dramco-iwast/motherboard/hardware/Motherboard v2/photo_2021-06-02_11-23-46.jpg

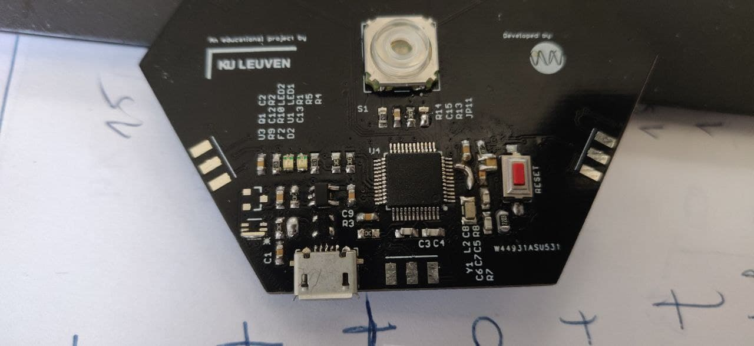
hardware/Motherboard v2/photo_2021-06-02_11-23-46.jpg
