dramco-iwast/motherboard/README.md

# motherboard
Design files (soft- and hardware) for the IWAST motherboard.

Needs reorganization.
