dramco-iwast/motherboard/hardware/Motherboard_v2_bom.xlsx

Qty | Value | Device | Package | Parts | Description | Manufacturer Part Number (MPN) | Ordercode Farnell | Ordercode Mouser | Type
2 |  | JUMPER-PAD-2-NC_BY_TRACENO_SILK | PAD-JUMPER-2-NC_BY_TRACE_NO_SILK | SJ1, SJ2
1 |  | JUMPER-SMT_3_1-NC_TRACE_SILK | SMT-JUMPER_3_1-NC_TRACE_SILK | JP11 | Normally closed trace jumper (1 of 2 connections)
2 |  | LEDCHIP-LED0603 | CHIP-LED0603 | LED1, LED2 | LED | KP-2012QBC-D | 2217974 |  | Tape en reel, afgesneden
1 |  | MOSFET_PCH-DMG2307L | SOT23-3 | Q1 | P-channel MOSFETs | DMG2307L | 2061518 |  | Tape en reel, afgesneden
1 |  | PINHD-1X1 | 1X01 | JP2 | PIN HEADER
6 |  | PINHD-2X3 | 2X03 | JP3, JP4, JP5, JP6, JP7, JP8 | PIN HEADER | M20-7830346 | 7991983 |  | Per stuk
1 |  | WE-CBA_0603(WB/HS) | WE-CBA_0603(W=2.2) | L2 | WE-CBA SMD EMI Suppression Ferrite Bead | 782631331 | 3551389 |  | Tape en reel, afgesneden
11 | 100n | C-EUC0603 | C0603 | C1, C2, C3, C4, C5, C8, C9, C12, C13, C15, C17 | CAPACITOR, European symbol | C0603C104Z4VACTU | 2522395 |  | Tape en reel, afgesneden
9 | 10k | R-EU_R0603 | R0603 | R3, R4, R5, R6, R7, R9, R10, R13, R14 | RESISTOR, European symbol | MC0100W0603110K | 2845751 |  | Tape en reel, afgesneden
1 | 10u | C-EUC0805 | C0805 | C16 | CAPACITOR, European symbol | C0805C106Z8VACTU | 2725611 |  | Reel
2 | 15p | C-EUC0603 | C0603 | C6, C7 | CAPACITOR, European symbol | C0603C150K4GACTU | 2773124 |  | Tape en reel, afgesneden
1 | 30062100 | 30062100 | 30062101 | S1 | Tactile Switches TACTILE | 30062114 |  | 979-3006.2114 | Not specified
1 | 32.768kHz | CRYSTAL3.2X1.5MM | CRYSTAL-SMD-3.2X1.5MM | Y1 | Various standard crystals. Proven footprints. | ABS07-32.768KHZ-T | 2101347 |  | Tape en reel, afgesneden
1 | 330 | R-EU_R0603 | R0603 | R8 | RESISTOR, European symbol | MCWR06X3300FTL | 2447339 |  | Tape en reel, afgesneden
2 | 470 | R-EU_R0603 | R0603 | R1, R2 | RESISTOR, European symbol | RC0603JR-07470RL | 9233334 |  | Tape en reel, afgesneden
1 | ATSAMD21G-A | ATSAMD21G-A | TQFP-48 | U4 | Atmel SAMD21G SMART ARM-Based Microcontroller | ATSAMD21G18A-AUT | 2775015 |  | Per stuk
1 | KSS-2EG4430 | KSS-2EG4430 | KSS-2EG4430 | RESET | Size: 3x6mm | PTS636 SM43 SMTR LFS |  | 611-PTS636SM43SMTRLF | Reel / afgesneden
1 | LM66100DCKR | LM66100DCKR | DCK6_TEX | U3 |  | LM66100DCKR |  | 595-LM66100DCKR | Reel / afgesneden
1 | LP2985AIM5-3.3 | LP2985AIM5-3.3 | SOT25 | U1 | LP2985-N Micropower 150 mA Low-Noise Ultra Low-Dropout Regulator | LP2985AIM5-3.3/NOPB | 3122185 |  | Tape en reel, afgesneden
1 | PPTC_6V500MA | PPTC_6V500MA | 805 | F2 | Resettable Fuse PPTC | SMD0805B050TF | 3052501 |  | Tape en reel, afgesneden
1 | PRTR5V0U2X,215 | PRTR5V0U2X,215 | SOT143B | D2 | Ultra low capacitance double rail-to-rail ESD protection diode Check prices | PRTR5V0U2X,215 | 1524157 |  | Tape en reel, afgesneden
1 | RN2483 | RN2483 | RN2483 | U2 | RN2483 Microchip Low-Power Lora Transceiver Module | RN2483A-I/RM104 | 2920841 |  | Per stuk
8 | TPB1,27 | TPB1,27 | B1,27 | TP1, TP2, TP3, TP4, TP5, TP6, TP7, TP8 | Test pad
1 | U.FL | U.FL | U.FL | J1 | SMD antenna connector- WRL-09144 | U.FL-R-SMT-1(10) | 1688077 |  | Tape en reel, afgesneden
1 | USB-RECEPTABLE | USB-RECEPTABLE | FCI-10103594-0001LF | USB1 | USB Receptable | 10118194-0001LF | 2668482 |  | Tape en reel, afgesneden
