dramco-iwast/motherboard/hardware/MotherBoard v1/Motherboard_v1_Bottom.pdf

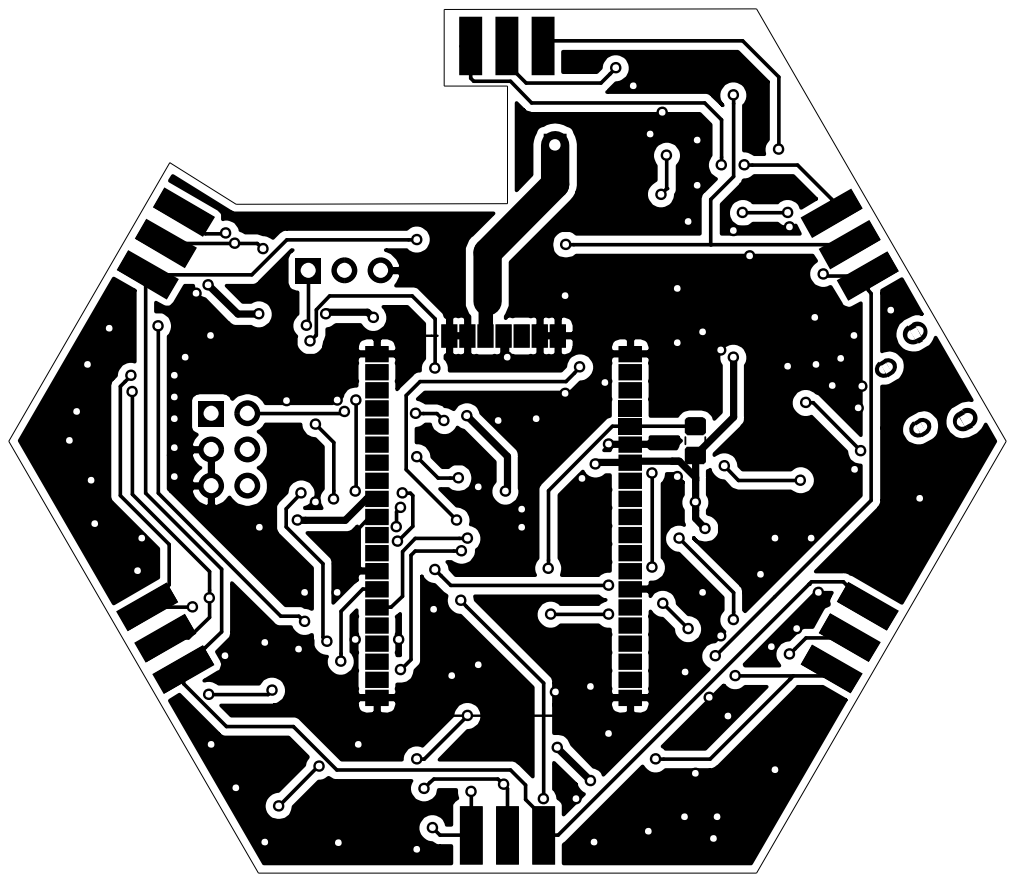
[picture p2: page 1]
