dramco-iwast/motherboard/hardware/MotherBoard v1/MotherBoard_v1_Schematic.pdf

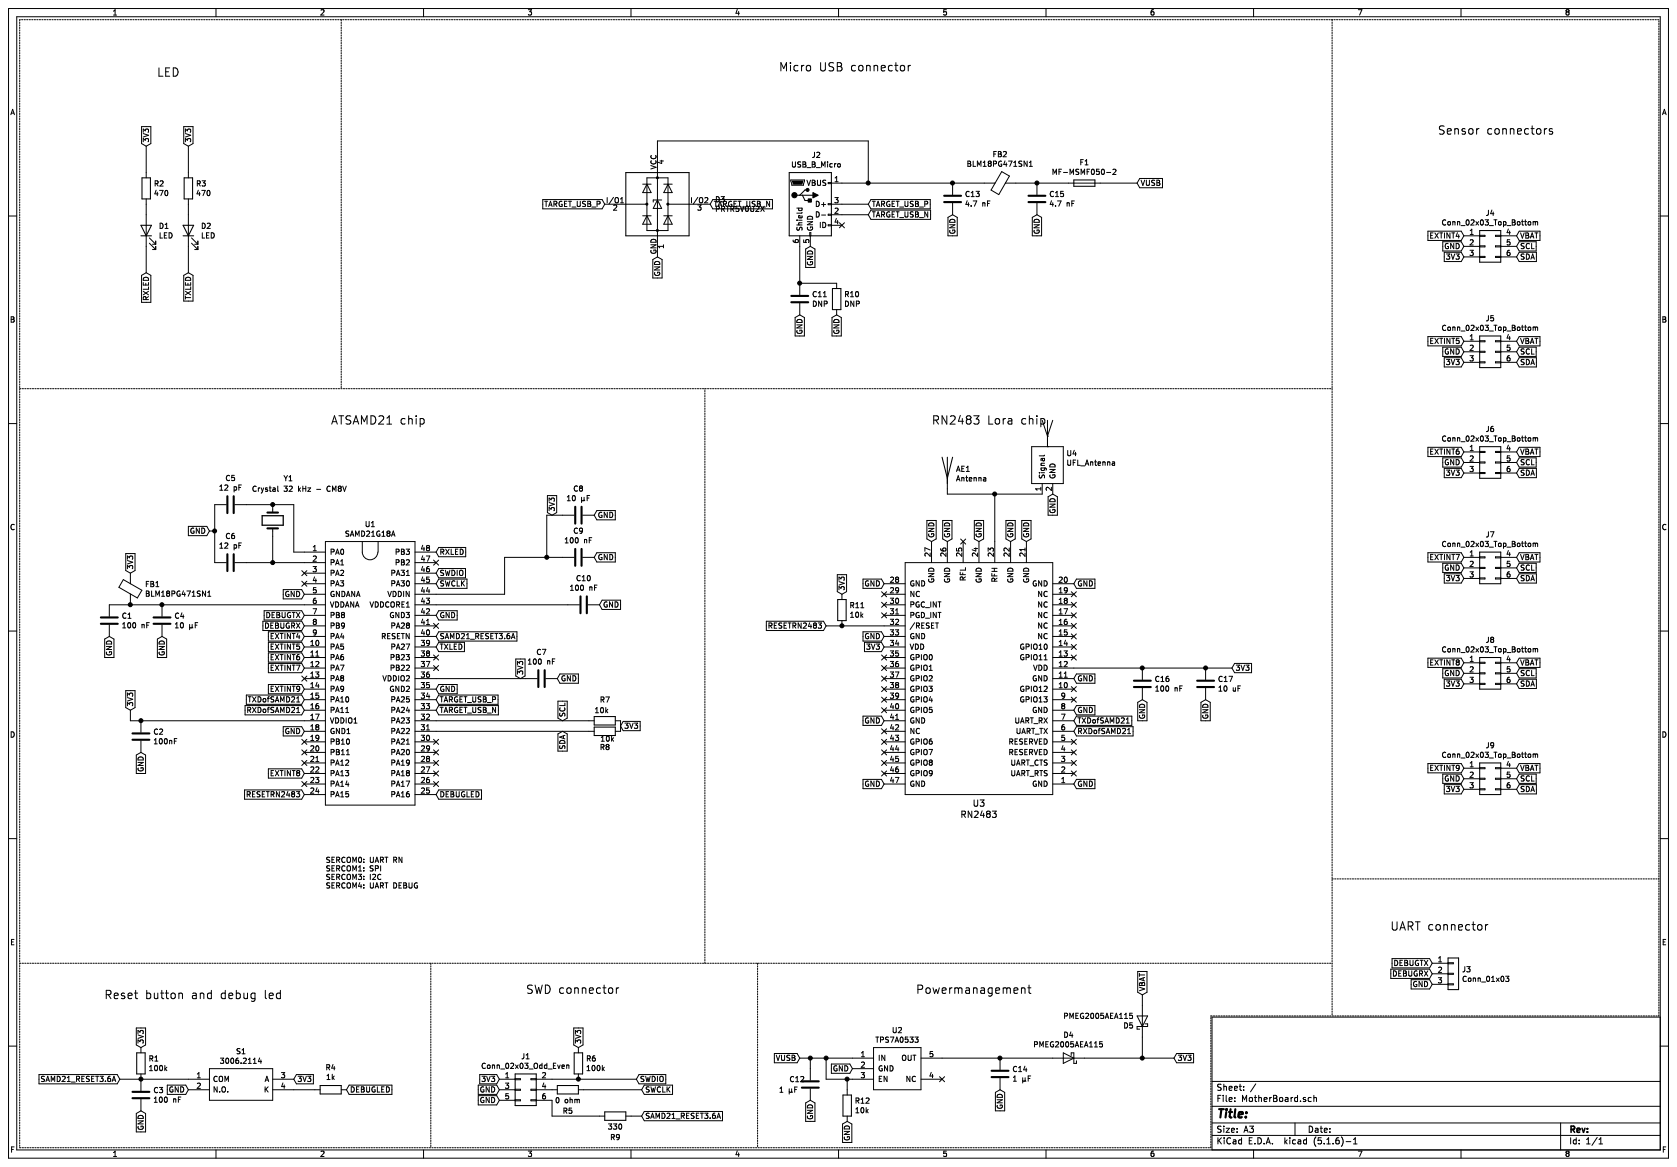
[picture p3: page 1]
