dramco-iwast/motherboard/hardware/MotherBoard v1/Motherboard_v1_Top.pdf

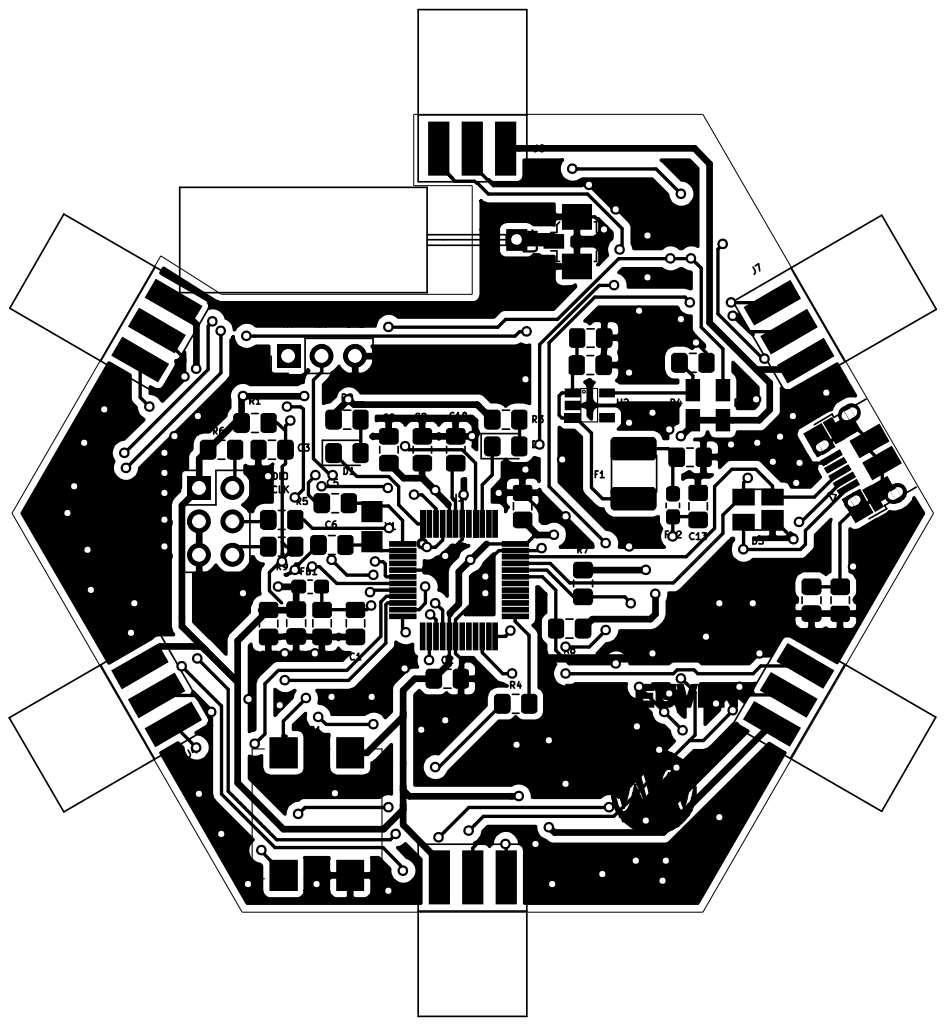
[picture p4: page 1]
