dramco-iwast/motherboard/hardware/MotherBoard v1/schematics/motherboard_back.pdf

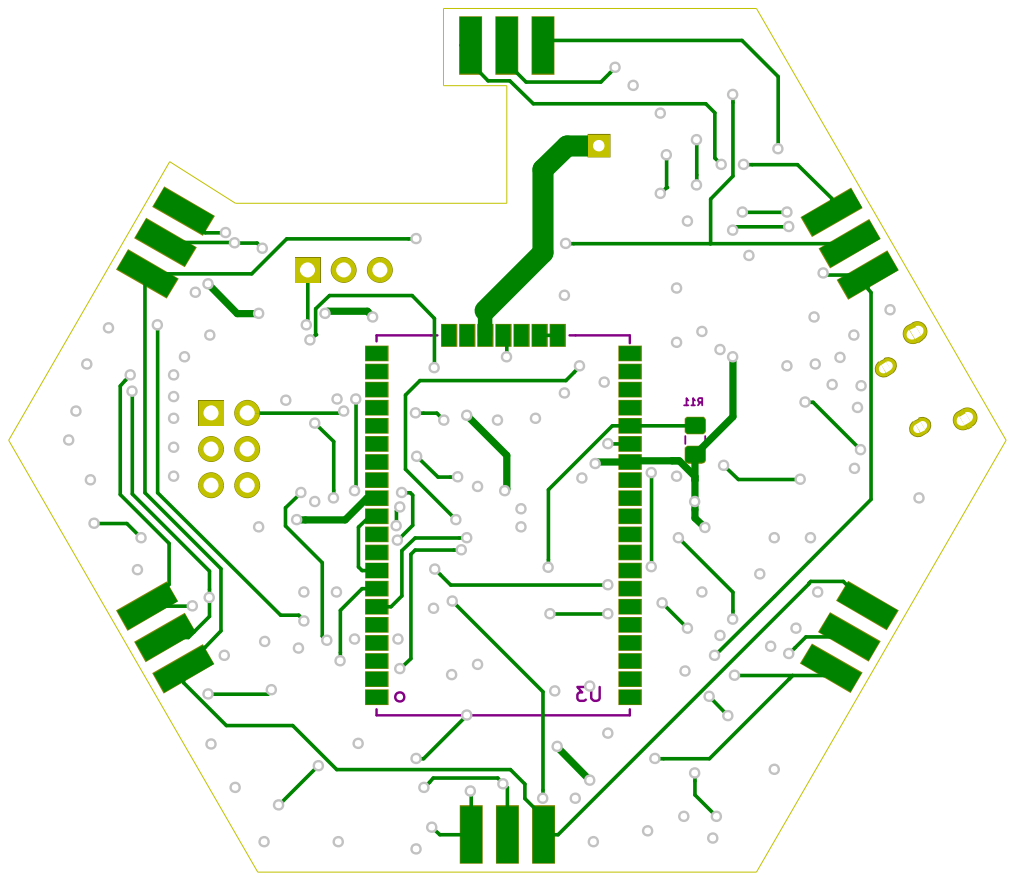
[picture p5: page 1]
