dramco-iwast/motherboard/hardware/MotherBoard v1/schematics/motherboard_front.pdf

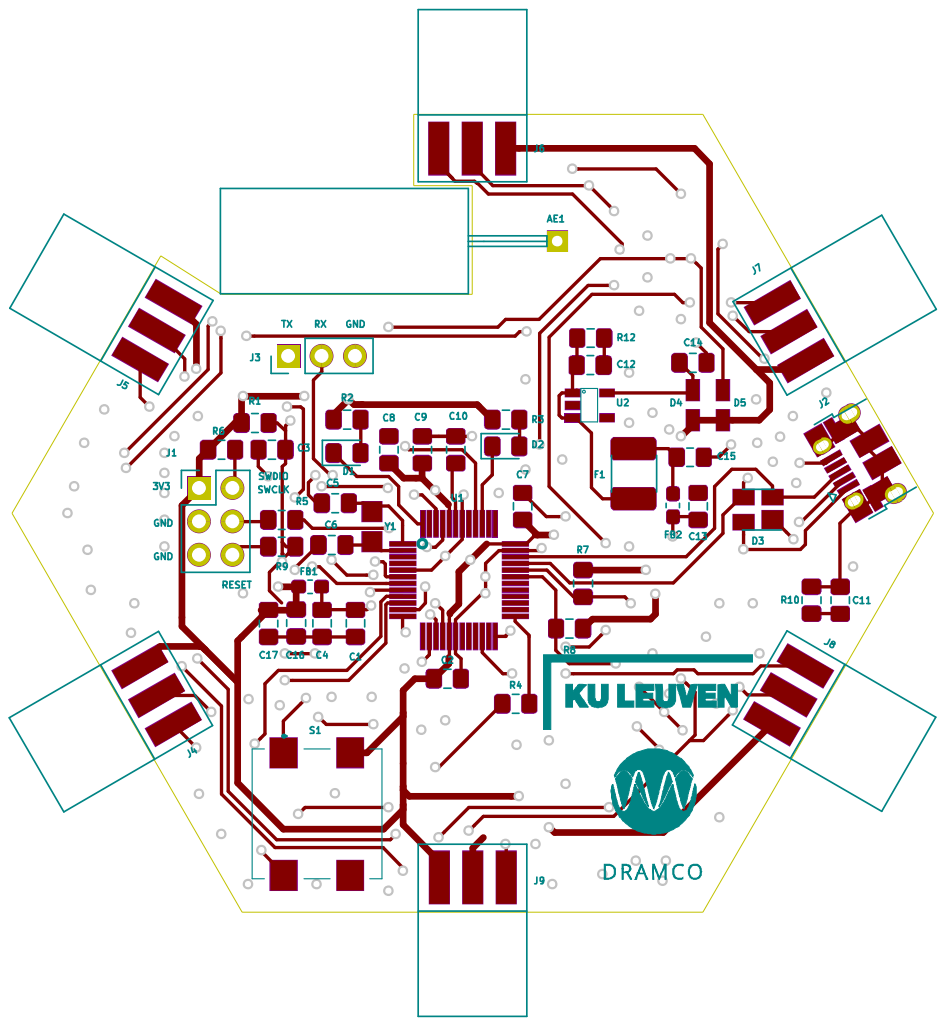
[picture p6: page 1]
