dramco-iwast/motherboard/hardware/MotherBoard v1/schematics/motherboard_schematic.pdf

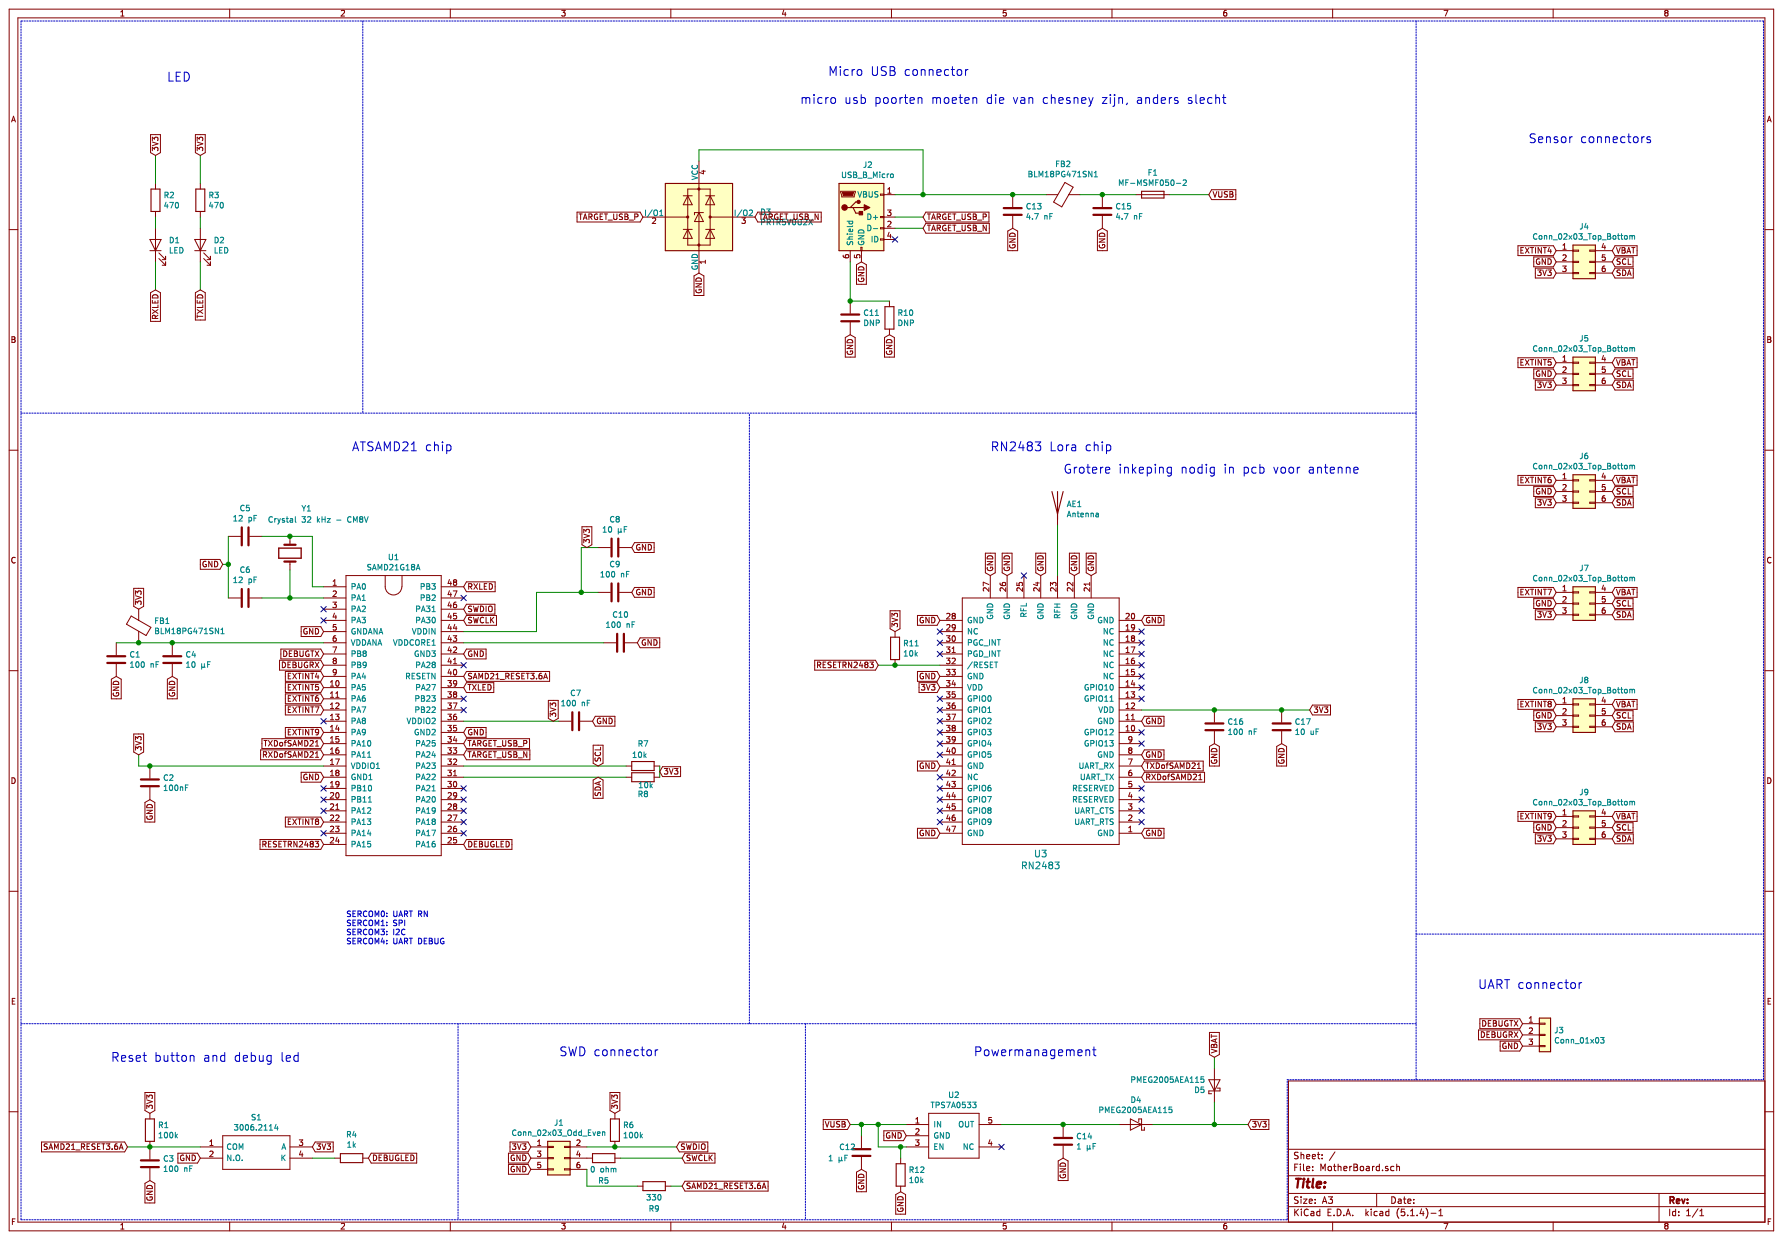
[picture p7: page 1]
