dramco-iwast/motherboard/hardware/MotherBoard v1/MotherBoard.kicad_pcb

## KiCad design hardware/MotherBoard v1/MotherBoard.kicad_pcb (2021-05-18)

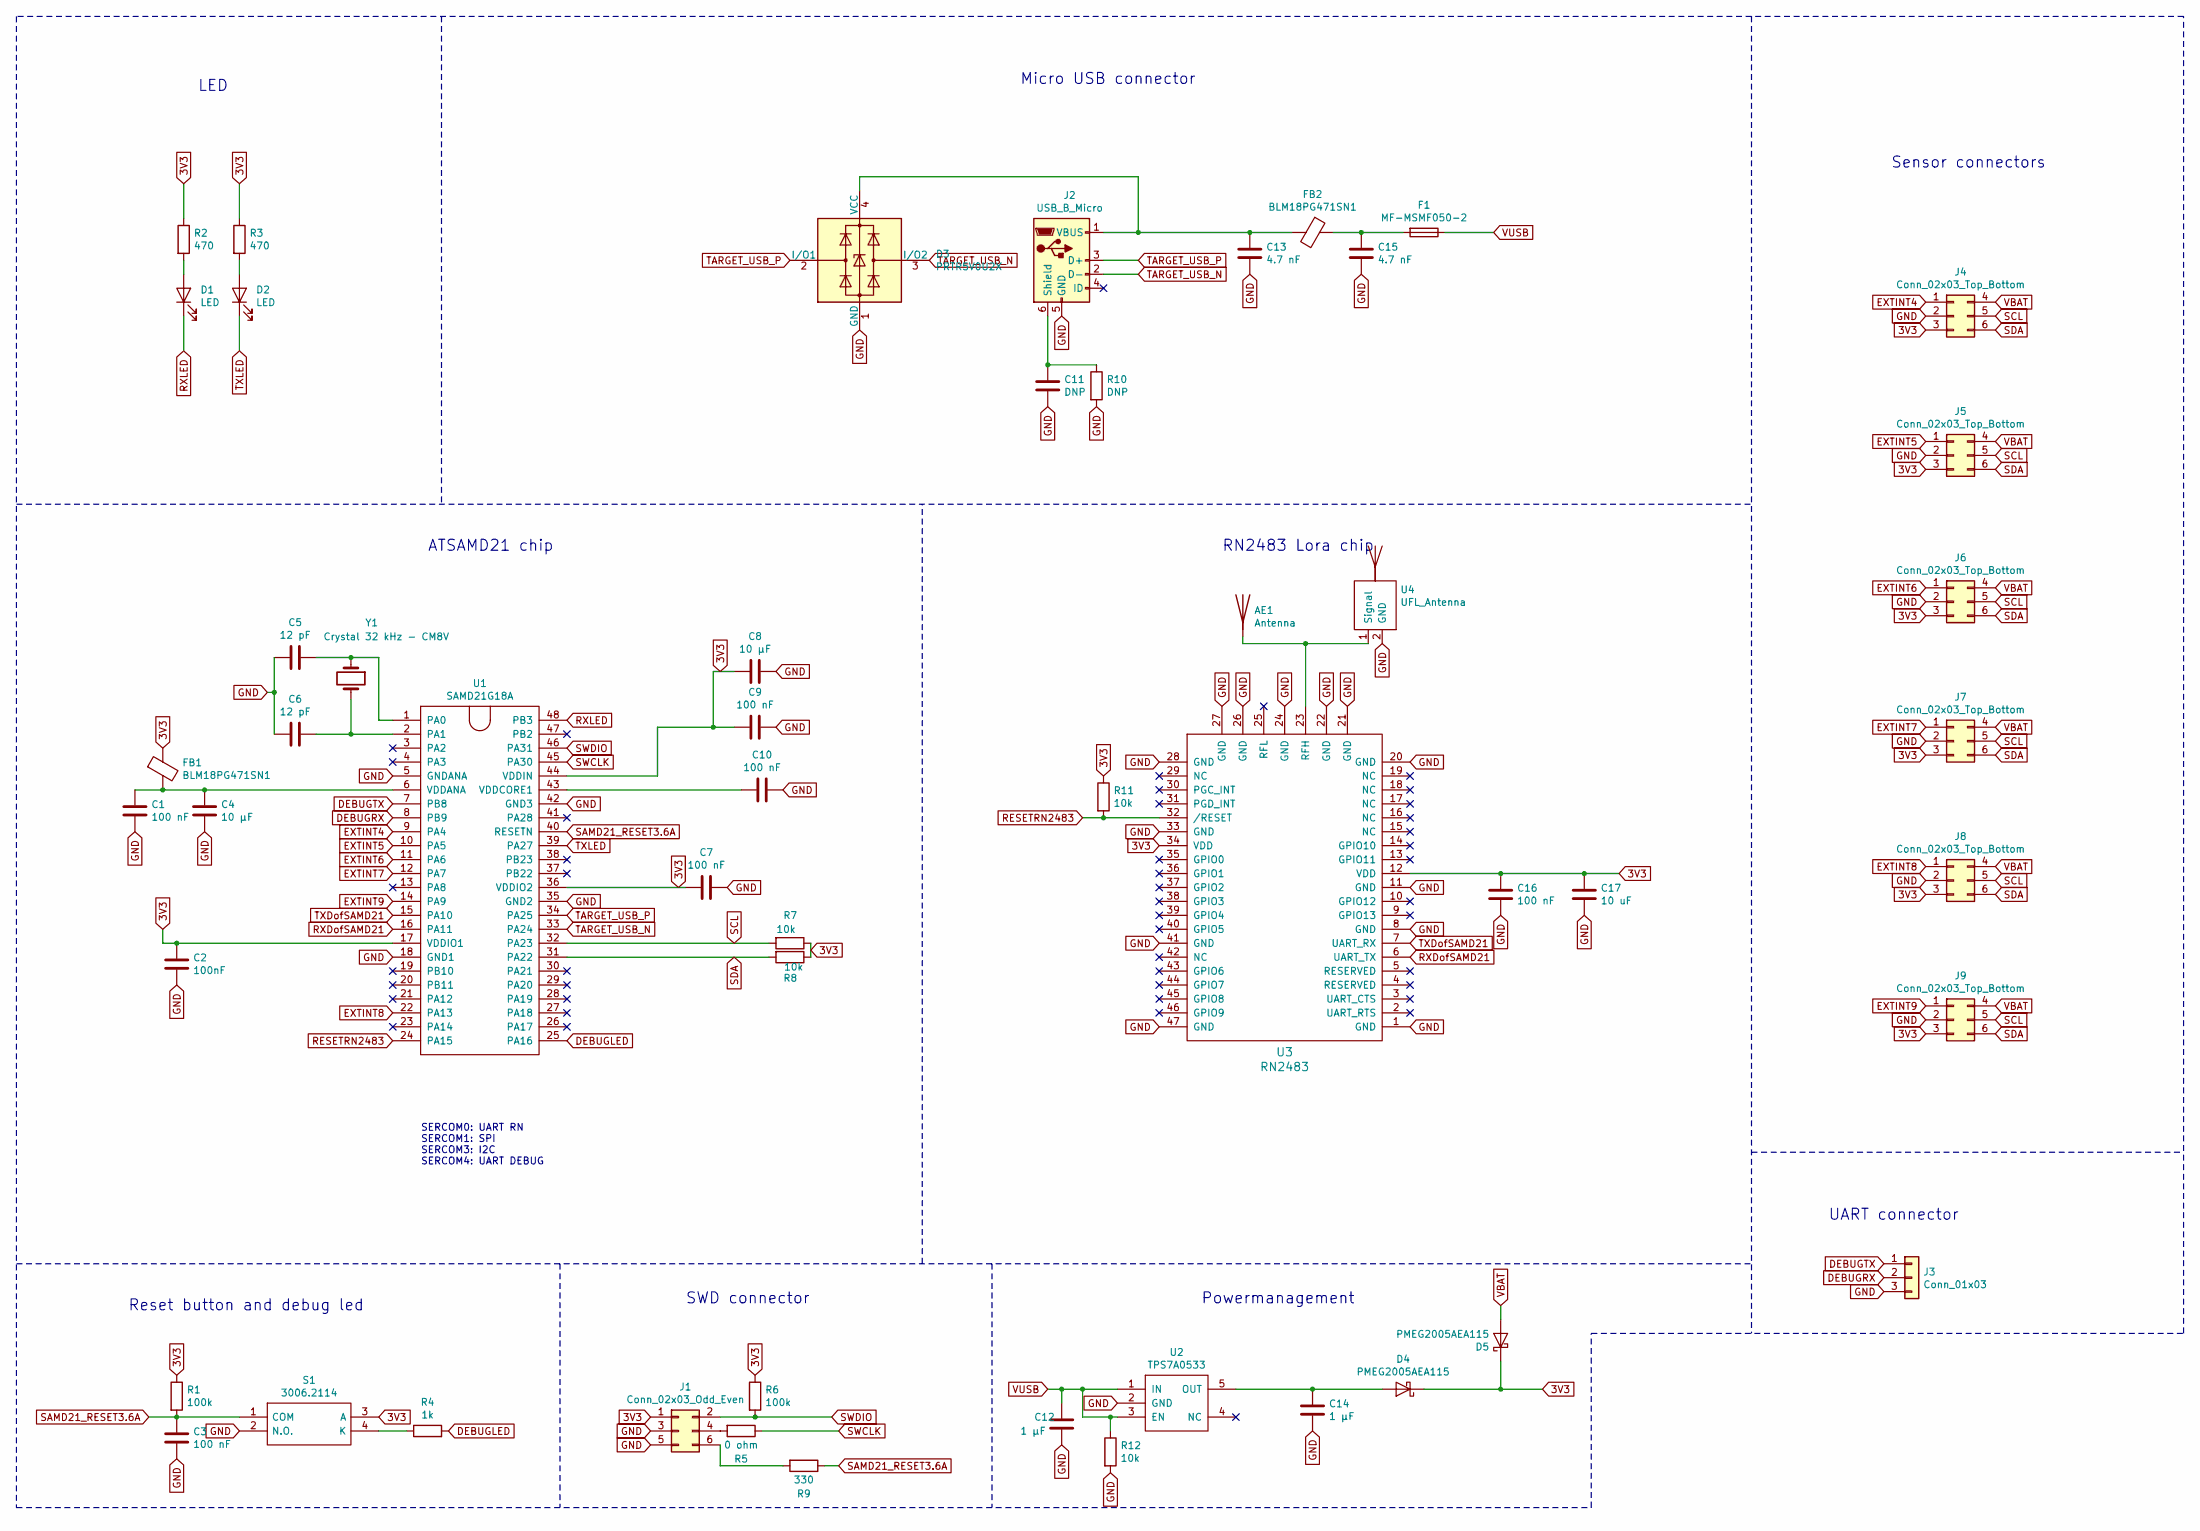
[picture p8: schematic MotherBoard.sch]

Parts:
AE1: Antenna; helixAntenna
C1, C3, C7, C9, C10, C16: 100 nF; C_0805_2012Metric_Pad1.15x1.40mm_HandSolder
C2: 100nF; C_0805_2012Metric_Pad1.15x1.40mm_HandSolder
C4, C8: 10 µF; C_0805_2012Metric_Pad1.15x1.40mm_HandSolder
C5, C6: 12 pF; C_0805_2012Metric_Pad1.15x1.40mm_HandSolder
C11: DNP; C_0805_2012Metric_Pad1.15x1.40mm_HandSolder
C12, C14: 1 µF; C_0805_2012Metric_Pad1.15x1.40mm_HandSolder
C13, C15: 4.7 nF; C_0805_2012Metric_Pad1.15x1.40mm_HandSolder
C17: 10 uF; C_0805_2012Metric_Pad1.15x1.40mm_HandSolder
D1, D2: LED; LED_0805_2012Metric_Pad1.15x1.40mm_HandSolder
D3: PRTR5V0U2X; SOT-143
D4, D5: PMEG2005AEA115; PMEG2005
F1: MF-MSMF050-2; MSMF050
FB1, FB2: BLM18PG471SN1; R_0603_1608Metric_Pad1.05x0.95mm_HandSolder
J1: Conn_02x03_Odd_Even; PinHeader_2x03_P2.54mm_Vertical
J2: USB_B_Micro; USB_Micro
J3: Conn_01x03; PinHeader_1x03_P2.54mm_Vertical
J4, J5, J6, J7, J8, J9: Conn_02x03_Top_Bottom; ConnectorHorizontalPcb
R1, R6: 100k; R_0805_2012Metric_Pad1.15x1.40mm_HandSolder
R2, R3: 470; R_0805_2012Metric_Pad1.15x1.40mm_HandSolder
R4: 1k; R_0805_2012Metric_Pad1.15x1.40mm_HandSolder
R5: 0 ohm; R_0805_2012Metric_Pad1.15x1.40mm_HandSolder
R7, R8, R11, R12: 10k; R_0805_2012Metric_Pad1.15x1.40mm_HandSolder
R9: 330; R_0805_2012Metric_Pad1.15x1.40mm_HandSolder
R10: DNP; R_0805_2012Metric_Pad1.15x1.40mm_HandSolder
S1: 3006.2114; 30062114; Manufacturer_Part_Number 3006.2114; Mouser Part Number 979-3006.2114
U1: SAMD21G18A; samd21
U2: TPS7A0533; TPS7A05
U3: RN2483
U4: UFL_Antenna; U.FL_Molex_MCRF_73412-0110_Vertical
Y1: Crystal 32 kHz - CM8V; crystelCM8V

Connections:
3V3: C2.1, C7.2, C8.2, C9.2, C16.1, C17.1, D4.1 (K), D5.1 (K), FB1.1, J1.1, J4.3, J5.3, J6.3, J7.3, J8.3, J9.3, R1.1, R2.1, R3.1, R6.1, R7.1, R8.1, R11.1, S1.3 (A), U1.17 (VDDIO1), U1.36 (VDDIO2), U1.44 (VDDIN), U3.12 (VDD), U3.34 (VDD)
DEBUGLED: R4.2, U1.25 (PA16)
DEBUGRX: J3.2, U1.8 (PB9)
DEBUGTX: J3.1, U1.7 (PB8)
EXTINT4: J4.1, U1.9 (PA4)
EXTINT5: J5.1, U1.10 (PA5)
EXTINT6: J6.1, U1.11 (PA6)
EXTINT7: J7.1, U1.12 (PA7)
EXTINT8: J8.1, U1.22 (PA13)
EXTINT9: J9.1, U1.14 (PA9)
GND: C1.2, C2.2, C3.2, C4.2, C5.2, C6.2, C7.1, C8.1, C9.1, C10.1, C11.2, C12.2, C13.2, C14.2, C15.2, C16.2, C17.2, D3.1 (GND), J1.3, J1.5, J2.5 (GND), J3.3, J4.2, J5.2, J6.2, J7.2, J8.2, J9.2, R10.2, R12.2, S1.2 (N.O.), U1.5 (GNDANA), U1.18 (GND1), U1.35 (GND2), U1.42 (GND3), U2.2 (GND), U3.1 (GND), U3.8 (GND), U3.11 (GND), U3.20 (GND), U3.21 (GND), U3.22 (GND), U3.24 (GND), U3.26 (GND), U3.27 (GND), U3.28 (GND), U3.33 (GND), U3.41 (GND), U3.47 (GND), U4.2 (GND)
unnamed: AE1.1, U3.23 (RFH), U4.1 (Signal)
unnamed: C1.1, C4.1, FB1.2, U1.6 (VDDANA)
unnamed: C5.1, U1.1 (PA0), Y1.1
unnamed: C6.1, U1.2 (PA1), Y1.2
unnamed: C10.2, U1.43 (VDDCORE1)
unnamed: C11.1, J2.6 (Shield), R10.1
unnamed: C13.1, D3.4 (VCC), FB2.2, J2.1 (VBUS)
unnamed: C14.1, D4.2 (A), U2.5 (OUT)
unnamed: C15.1, F1.2, FB2.1
unnamed: D1.2 (A), R2.2
unnamed: D2.2 (A), R3.2
unnamed: J1.4, R5.2
unnamed: J1.6, R9.2
unnamed: R4.1, S1.4 (K)
RESETRN2483: R11.2, U1.24 (PA15), U3.32 (/RESET)
RXDofSAMD21: U1.16 (PA11), U3.6 (UART_TX)
RXLED: D1.1 (K), U1.48 (PB3)
SAMD21_RESET3.6A: C3.1, R1.2, R9.1, S1.1 (COM), U1.40 (RESETN)
SCL: J4.5, J5.5, J6.5, J7.5, J8.5, J9.5, R7.2, U1.32 (PA23)
SDA: J4.6, J5.6, J6.6, J7.6, J8.6, J9.6, R8.2, U1.31 (PA22)
SWCLK: R5.1, U1.45 (PA30)
SWDIO: J1.2, R6.2, U1.46 (PA31)
TARGET_USB_N: D3.3 (I/O2), J2.2 (D-), U1.33 (PA24)
TARGET_USB_P: D3.2 (I/O1), J2.3 (D+), U1.34 (PA25)
TXDofSAMD21: U1.15 (PA10), U3.7 (UART_RX)
TXLED: D2.1 (K), U1.39 (PA27)
VBAT: D5.2 (A), J4.4, J5.4, J6.4, J7.4, J8.4, J9.4
VUSB: C12.1, F1.1, R12.1, U2.1 (IN), U2.3 (EN)

Notes on the sheet:
SERCOM0: UART RN SERCOM1: SPI SERCOM3: I2C SERCOM4: UART DEBUG
Reset button and debug led
SWD connector
Powermanagement
UART connector
Sensor connectors
ATSAMD21 chip
LED
Micro USB connector
RN2483 Lora chip

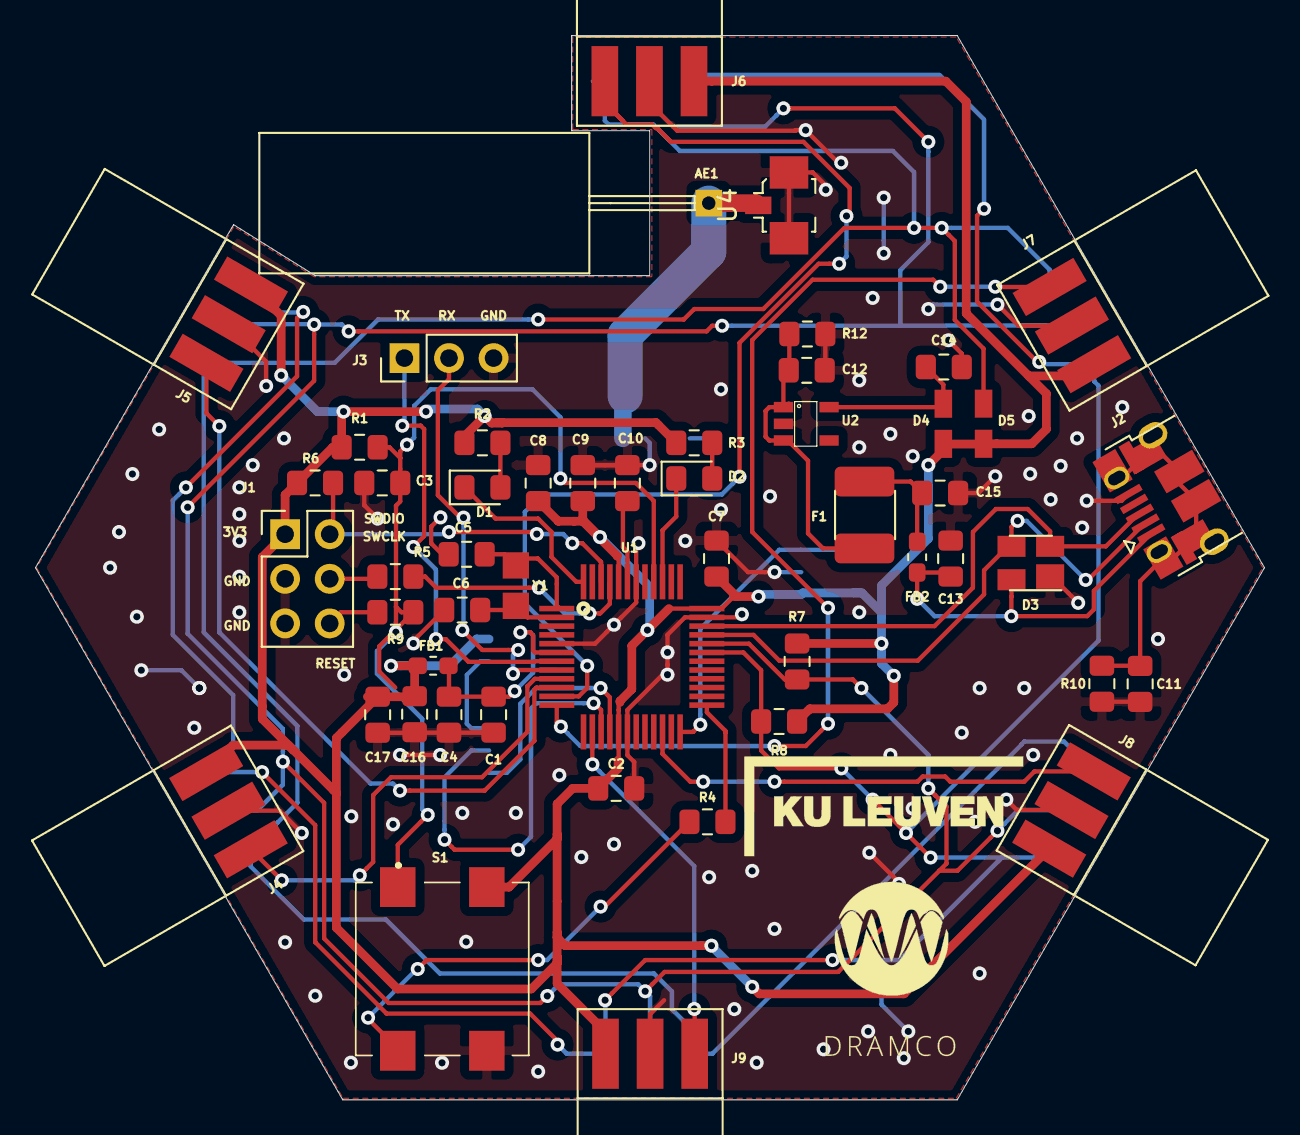
[picture p9: board MotherBoard.kicad_pcb from above]

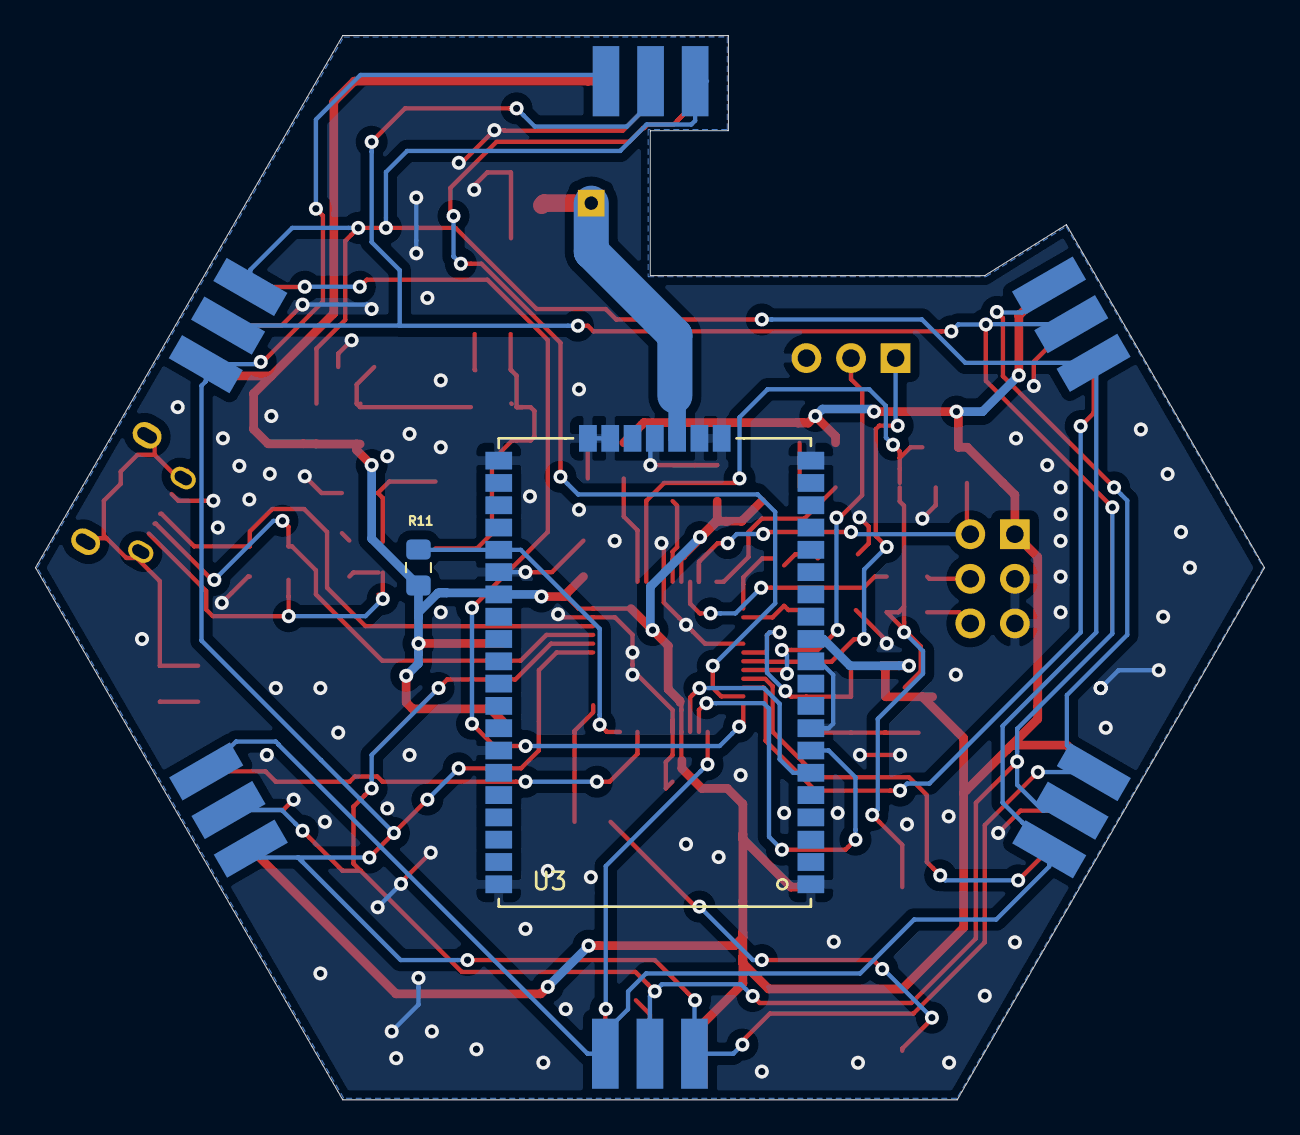
[picture p10: board MotherBoard.kicad_pcb from below]

Board: 2 copper layers, 70.0 x 60.6 mm, 53 parts (2 on the bottom side), 39 nets.
