dramco-iwast/motherboard/hardware/Motherboard v2/Versie 4.brd

## EAGLE design hardware/Motherboard v2/Versie 4.brd (2022-01-26)

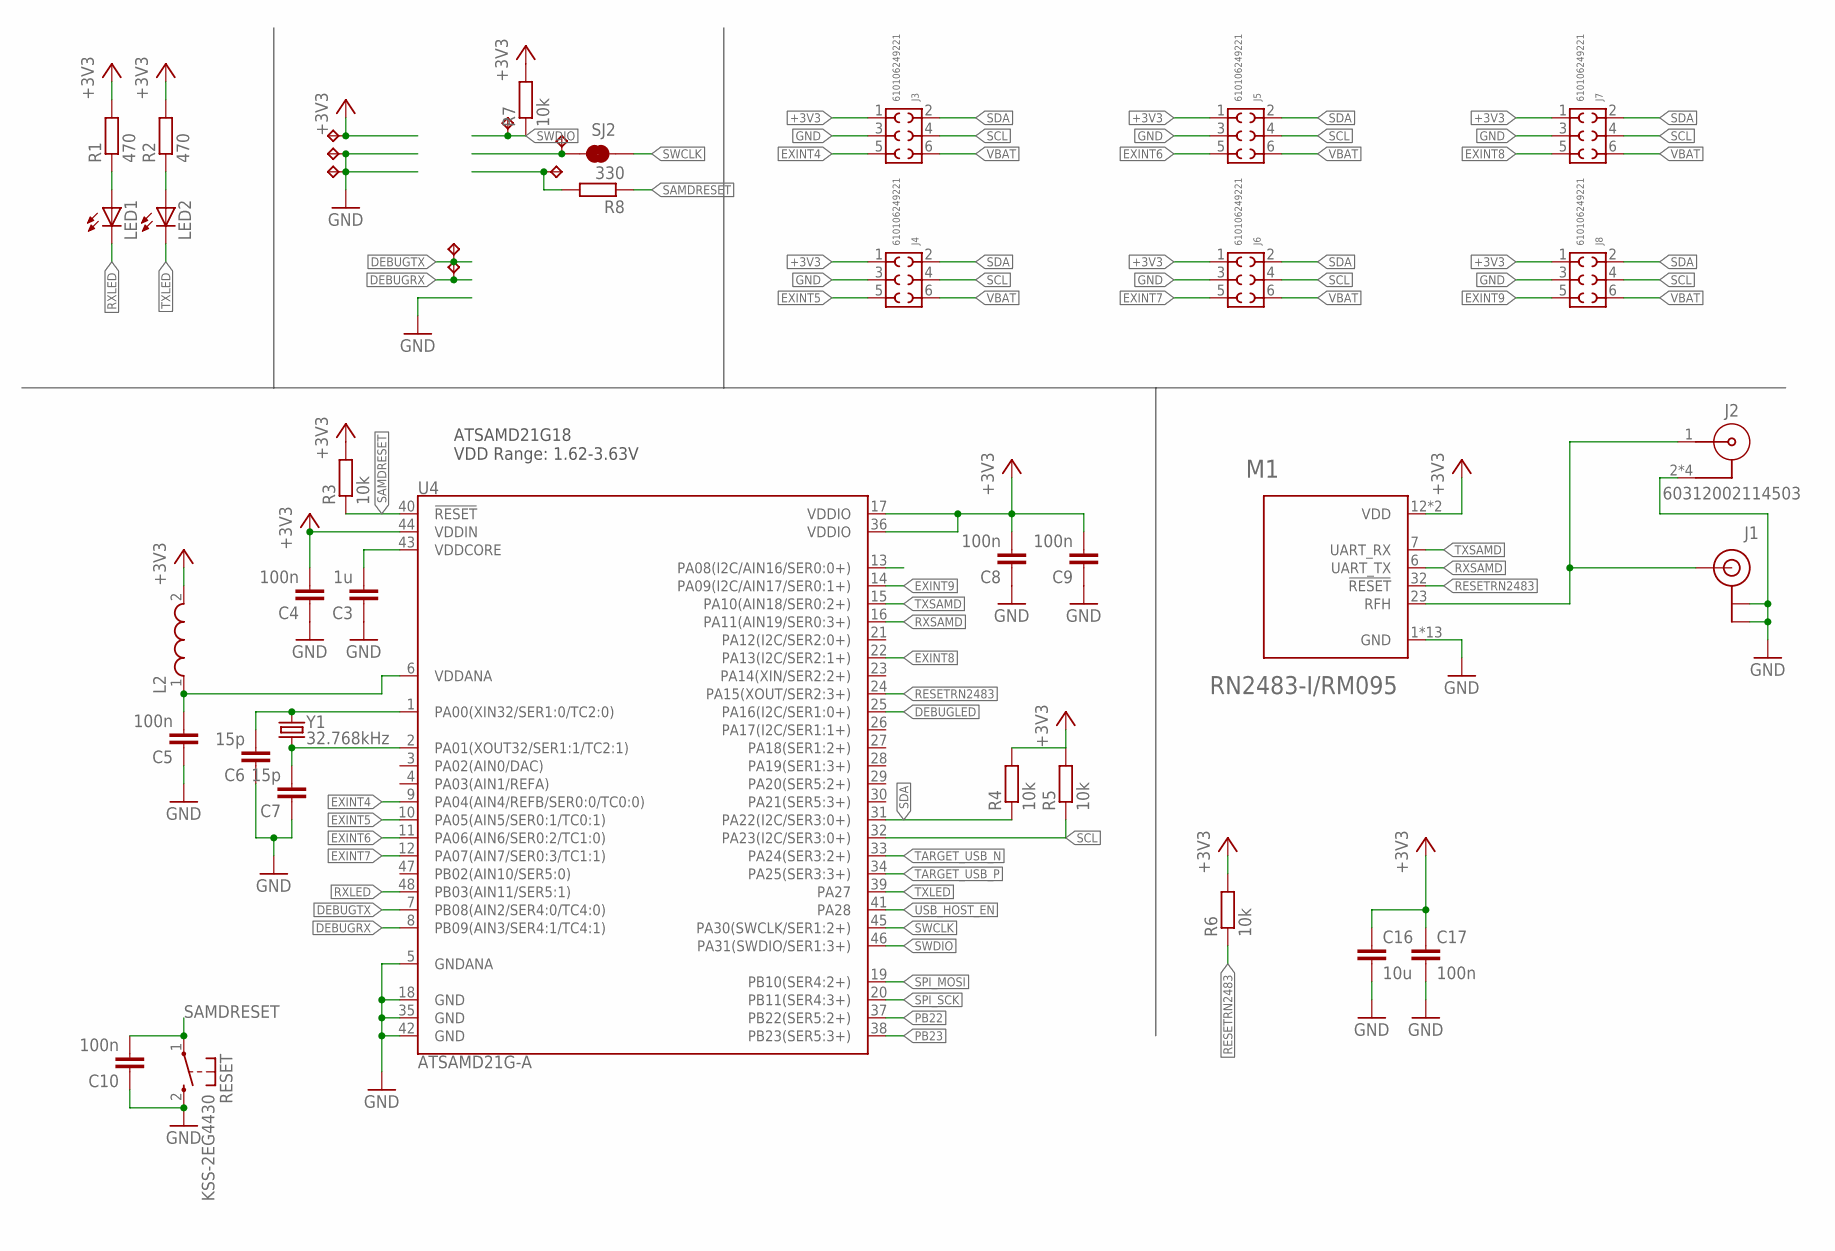
[picture p11: schematic Versie 4.sch, sheet 1]

Parts:
C3: 1u; C0603
C4, C5, C8, C9, C10, C17: 100n; C0603
C6, C7: 15p; C0603
C16: 10u; C0805
J1: U.FL
J2: 60312002114503
J3, J4, J5, J6, J7, J8: 610106249221
L2: WE-CBA_0603(WB/HS); WE-CBA_0603(W=2.2)
LED1, LED2: LEDCHIP-LED0603; CHIP-LED0603
M1: RN2483-I/RM095; MICROCHIP_RN2483-I/RM095
R1, R2: 470; R0603
R3, R4, R5, R6, R7: 10k; R0603
R8: 330; R0603
RESET: KSS-2EG4430
SJ2: JUMPER-PAD-2-NC_BY_TRACENO_SILK; PAD-JUMPER-2-NC_BY_TRACE_NO_SILK
TP1, TP2, TP3, TP4, TP5, TP6, TP7, TP8: TPB1,27; B1,27
U4: ATSAMD21G-A; TQFP-48
Y1: 32.768kHz; CRYSTAL-SMD-3.2X1.5MM

Connections:
+3V3: C4.2, C8.2, C9.2, C16.1, C17.1, J3.1, J4.1, J5.1, J6.1, J7.1, J8.1, L2.2, M1.12 (VDD), M1.34 (VDD), R1.2, R2.2, R3.2, R4.2, R5.2, R6.2, R7.2, TP1.TP, U4.17 (VDDIO), U4.36 (VDDIO), U4.44 (VDDIN); also elsewhere on the board
BUTTON: U4.13 (PA08(I2C/AIN16/SER0:0+)); also elsewhere on the board
DEBUGLED: U4.25 (PA16(I2C/SER1:0+)); also elsewhere on the board
DEBUGRX: TP8.TP, U4.8 (PB09(AIN3/SER4:1/TC4:1))
DEBUGTX: TP7.TP, U4.7 (PB08(AIN2/SER4:0/TC4:0))
EXINT4: J3.5, U4.9 (PA04(AIN4/REFB/SER0:0/TC0:0))
EXINT5: J4.5, U4.10 (PA05(AIN5/SER0:1/TC0:1))
EXINT6: J5.5, U4.11 (PA06(AIN6/SER0:2/TC1:0))
EXINT7: J6.5, U4.12 (PA07(AIN7/SER0:3/TC1:1))
EXINT8: J7.5, U4.22 (PA13(I2C/SER2:1+))
EXINT9: J8.5, U4.14 (PA09(I2C/AIN17/SER0:1+))
GND: C3.1, C4.1, C5.1, C6.1, C7.1, C8.1, C9.1, C10.1, C16.2, C17.2, J1.P$1 (GND), J1.P$2 (GND), J2.2, J2.3 (2), J2.4 (2), J2.5 (2), J3.3, J4.3, J5.3, J6.3, J7.3, J8.3, M1.1 (GND), M1.8 (GND), M1.11 (GND), M1.20 (GND), M1.21 (GND), M1.22 (GND), M1.24 (GND), M1.26 (GND), M1.27 (GND), M1.28 (GND), M1.33 (GND), M1.41 (GND), M1.47 (GND), RESET.2 (S), TP2.TP, TP3.TP, U4.5 (GNDANA), U4.18 (GND), U4.35 (GND), U4.42 (GND); also elsewhere on the board
unnamed: LED1.A, R1.1
unnamed: LED2.A, R2.1
unnamed: SJ2.2, TP5.TP
unnamed: C6.2, U4.1 (PA00(XIN32/SER1:0/TC2:0)), Y1.P$2 (2)
unnamed: C7.2, U4.2 (PA01(XOUT32/SER1:1/TC2:1)), Y1.P$1 (1)
unnamed: C5.2, L2.1, U4.6 (VDDANA)
unnamed: J1.P$3 (SIGNAL), J2.1, M1.23 (RFH)
unnamed: R8.2, TP6.TP
PB22: U4.37 (PB22(SER5:2+))
PB23: U4.38 (PB23(SER5:3+))
RESETRN2483: M1.32 (!RESET), R6.1, U4.24 (PA15(XOUT/SER2:3+))
RXLED: LED1.C, U4.48 (PB03(AIN11/SER5:1))
RXSAMD: M1.6 (UART_TX), U4.16 (PA11(AIN19/SER0:3+))
SAMDRESET: C10.2, R3.1, R8.1, RESET.1, U4.40 (!RESET!); also elsewhere on the board
SCL: J3.4, J4.4, J5.4, J6.4, J7.4, J8.4, R5.1, U4.32 (PA23(I2C/SER3:0+))
SDA: J3.2, J4.2, J5.2, J6.2, J7.2, J8.2, R4.1, U4.31 (PA22(I2C/SER3:0+))
SPI_MOSI: U4.19 (PB10(SER4:2+))
SPI_SCK: U4.20 (PB11(SER4:3+))
SWCLK: SJ2.1, U4.45 (PA30(SWCLK/SER1:2+))
SWDIO: R7.1, TP4.TP, U4.46 (PA31(SWDIO/SER1:3+))
TARGET_USB_N: U4.33 (PA24(SER3:2+)); also elsewhere on the board
TARGET_USB_P: U4.34 (PA25(SER3:3+)); also elsewhere on the board
TXLED: LED2.C, U4.39 (PA27)
TXSAMD: M1.7 (UART_RX), U4.15 (PA10(AIN18/SER0:2+))
USB_HOST_EN: U4.41 (PA28)
VBAT: J3.6, J4.6, J5.6, J6.6, J7.6, J8.6; also elsewhere on the board
VDDCORE: C3.2, U4.43 (VDDCORE)

Notes on the sheet:
ATSAMD21G18 VDD Range: 1.62-3.63V

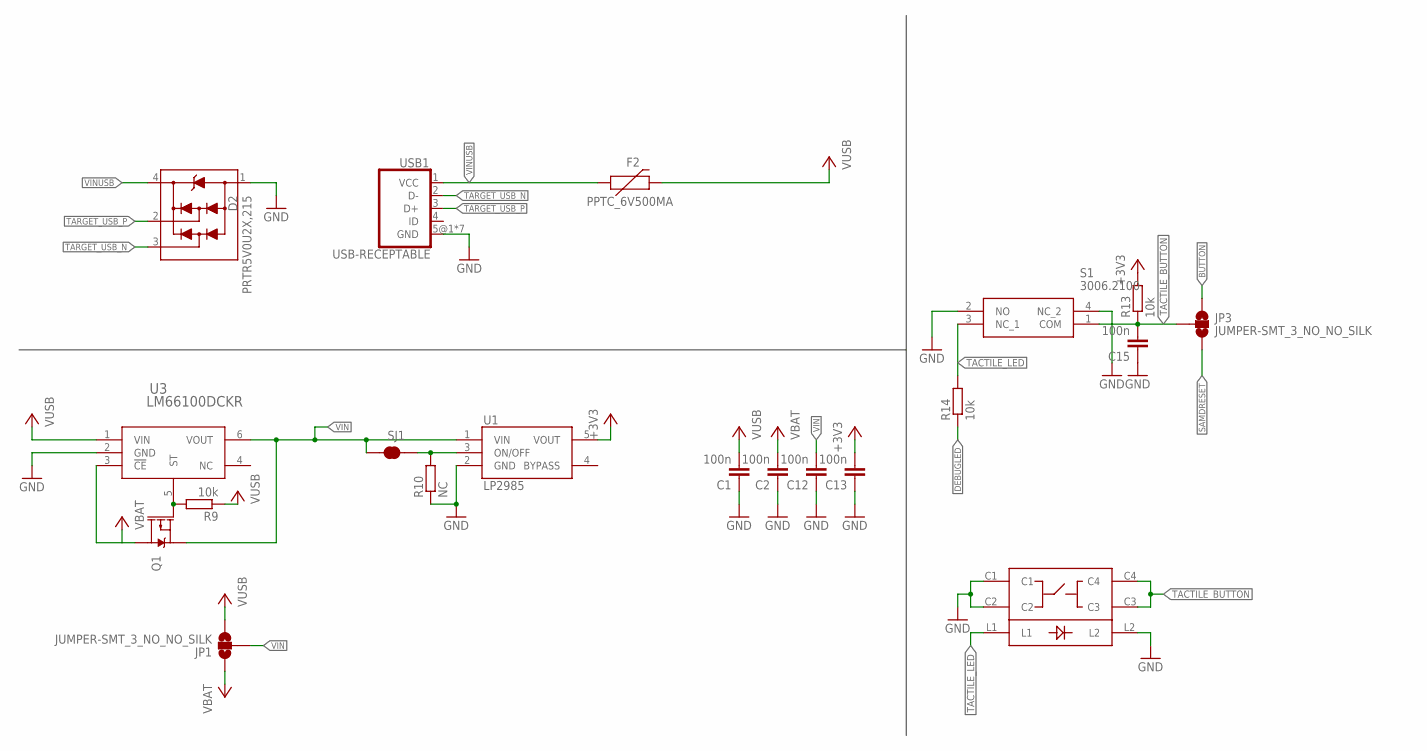
[picture p12: schematic Versie 4.sch, sheet 2]

Parts:
C1, C2, C12, C13, C15: 100n; C0603
D2: PRTR5V0U2X,215; SOT143B
F2: PPTC_6V500MA; 0805
JP1, JP3: JUMPER-SMT_3_NO_NO_SILK; SMT-JUMPER_3_0-NO_TRACE_NO-SILK
Q1: MOSFET_PCH-DMG2307L; SOT23-3
R9, R13, R14: 10k; R0603
R10: NC; R0603
S1: 3006.2100; 30062101
SJ1: JUMPER-PAD-2-NC_BY_TRACENO_SILK; PAD-JUMPER-2-NC_BY_TRACE_NO_SILK
U1: LP2985AIM5-3.3; SOT25
U3: LM66100DCKR; DCK6_TEX
U$1: LS1201
USB1: USB-RECEPTABLE; FCI-10103594-0001LF

Connections:
+3V3: C13.2, R13.2, U1.5 (VOUT); also elsewhere on the board
BUTTON: JP3.1; also elsewhere on the board
DEBUGLED: R14.1; also elsewhere on the board
GND: C1.1, C2.1, C12.1, C13.1, C15.1, D2.1, R10.1, S1.2 (NO), S1.4 (NC_2), U1.2 (GND), U3.2 (GND), U$1.C1, U$1.C2, U$1.L2, USB1.5@1 (GND), USB1.5@2 (GND), USB1.5@3 (GND), USB1.5@4 (GND), USB1.5@5 (GND), USB1.5@6 (GND), USB1.5@7 (GND); also elsewhere on the board
unnamed: Q1.1 (G), R9.2, U3.5 (ST)
ONOFF: R10.2, SJ1.1, U1.3 (ON/OFF)
SAMDRESET: JP3.3; also elsewhere on the board
TACTILE_BUTTON: C15.2, JP3.2, R13.1, S1.1 (COM), U$1.C3, U$1.C4
TACTILE_LED: R14.2, S1.3 (NC_1), U$1.L1
TARGET_USB_N: D2.3, USB1.2 (D-); also elsewhere on the board
TARGET_USB_P: D2.2, USB1.3 (D+); also elsewhere on the board
VBAT: C2.2, JP1.1, Q1.3 (D), U3.3 (!CE); also elsewhere on the board
VIN: C12.2, JP1.2, Q1.2 (S), SJ1.2, U1.1 (VIN), U3.6 (VOUT)
VINUSB: D2.4, F2.1, USB1.1 (VCC)
VUSB: C1.2, F2.2, JP1.3, R9.1, U3.1 (VIN)

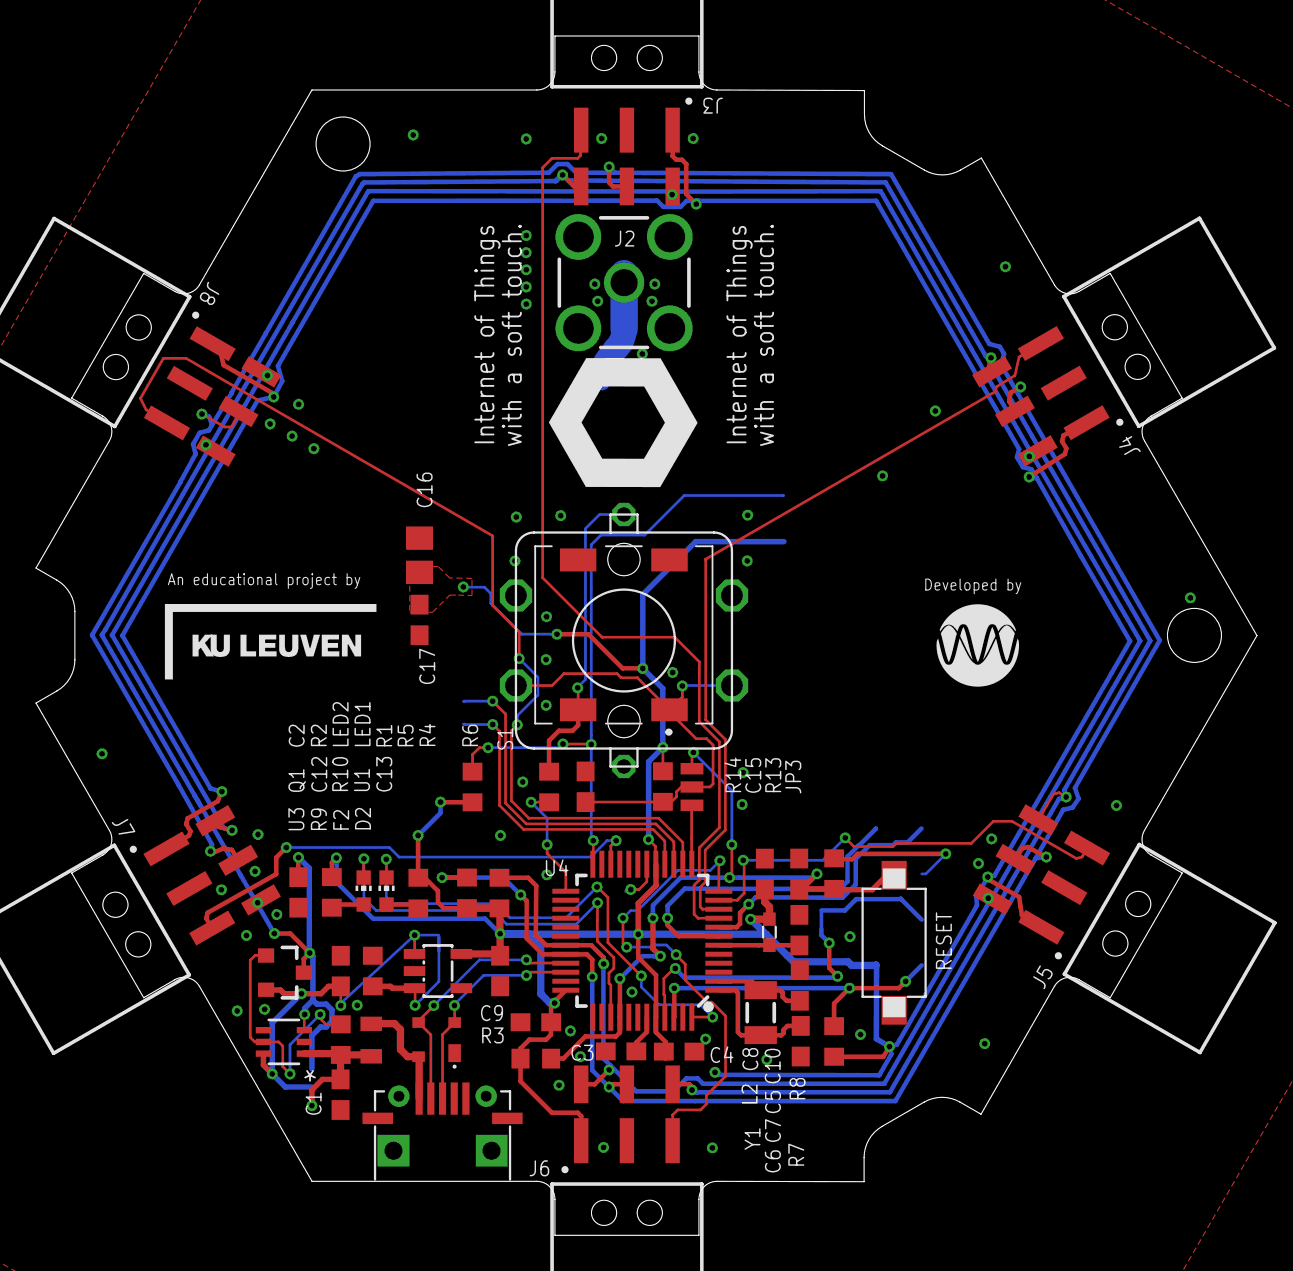
[picture p13: board Versie 4.brd from above]

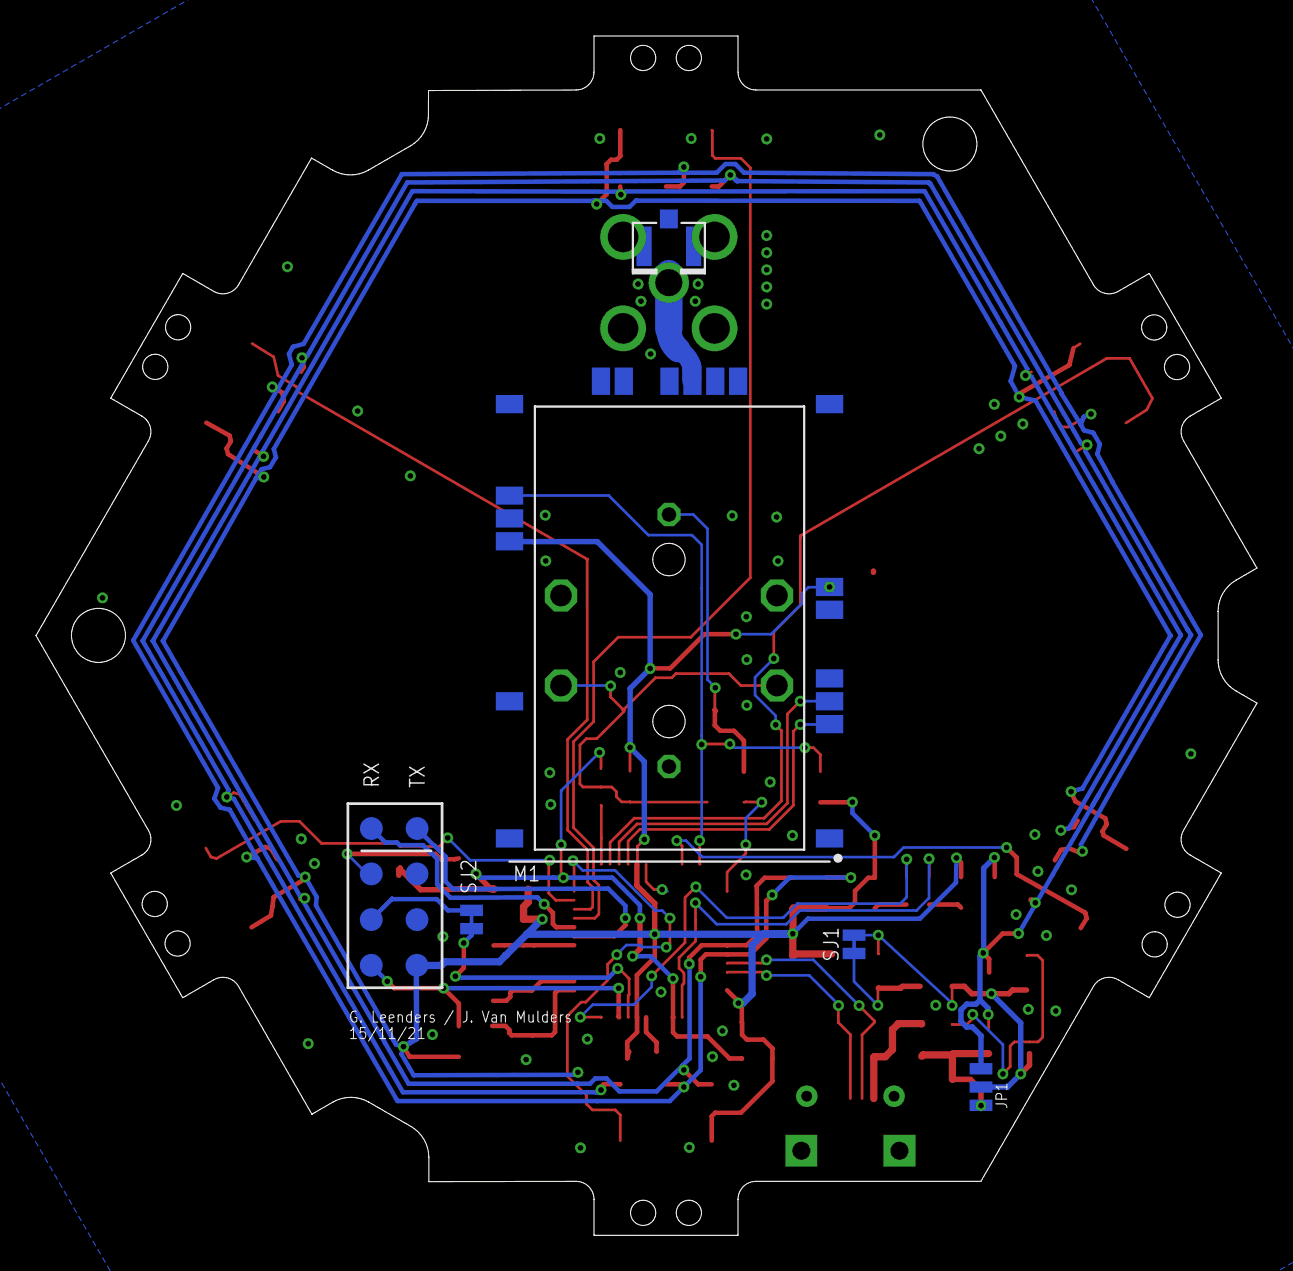
[picture p14: board Versie 4.brd from below]

Board: 2 copper layers, 67.8 x 66.6 mm, 62 parts (13 on the bottom side), 41 nets.
