dramco-iwast/motherboard/(commit log)

2019-10-24 Functionality update
    Added library for LoRaWAN connectivity
    Added Sensor class (not tested yet)
    Added NonVolatileConfig class (not tested yet)
2019-11-05 Support for polled sensing
    Partly tested (support for multiple metrics/sensor is still under development)
2019-11-14 Working NodeManager
    Added extra hardware serial for debugging (because Native USB looses connection in sleep).
    Nodemanager tested with 2 sensors (both polled and interrupt-based operation). Currently no multi-metric sensor support.
    [main.cpp]
2019-11-18 Low power testing
2019-11-20 Temporary update
    Used new low power library.
    Changed file structure of LoRa library.
2019-12-10 Low-power LoRa operation (modem sleep)
2020-01-20 Bug fix in NodeManager
    Wrong callback for sixth interrupt pin
    [device_settings.h]
2020-10-08 Updated NodeManager and LoRaWAN
    Periodic wake-up every 60 seconds. Sleep can be interrupted without impacting the wake-up period.
    Added LED to LoRaWAN library
2020-10-15 Update platformio.ini
    VERY_LOW_POWER build flag is essential for µA sleep currents
2020-10-15 ArduinoLowPower
    Added time-keeping to ArduinoLowPower
2020-10-21 Update ArduinoLowPower
    Sleep() can be used to sleep until previously set alarm
2020-10-21 Update DebugSerial.h
    Added include guards
    Added function to print byte buffer in hex format
2020-10-22 Update Sensor.cpp
    Clean-up.
2020-10-22 Update Sensor.h
    New define.
2020-11-04 Added watchdog for stability
    Still in testing phase
    [main.cpp]
2020-11-12 Watchdog reset is used to skip configuration phase
    [main.cpp]
2020-12-14 Motherboard v2
    Made by Guus
    [Versie 1.GBL, Versie 1.GBO, Versie 1.GBP, Versie 1.GBS, Versie 1.GTL, Versie 1.GTO, Versie 1.GTP, Versie 1.GTS]
2021-02-19 NodeManager updated
    System reset when connected sensors do not match with the stored configuration.
2021-05-18 Cleanup hardware
    [MotherBoard.csv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]
2021-06-03 Update LoRaWAN.cpp
    Updated LED control for the new motherboard hardware
2021-09-03 Hardware v2
    [Versie 1.GBL, Versie 1.GBO, Versie 1.GBP, Versie 1.GBS, Versie 1.GTL, Versie 1.GTO, Versie 1.GTP, Versie 1.GTS]
2021-09-17 Update lora led operation
2022-01-18 Custom ArduinoLowPower
2022-01-26 Added hardware v4
    [Versie 4.brd, Versie 4.sch]
2022-02-23 start led board v1
2022-02-23 flash couple of times
2022-02-25 Update NodeManager.cpp
    derive board id from deviceEUI
