dramco-iwast/motherboard/(notices)

Notices in the files:
parts and their libraries:
SparkFun-Fuses: Licensing: Creative Commons ShareAlike 4.0 International - https://creativecommons.org/licenses/by-sa/4.0
EagleLibrary_Wuerth_Elektronik_eiSos_rev: Copyright: Würth Elektronik
COPYRIGHT: Copyright (C) 2018 Accelerated Designs. All rights reserved
